Railstars/Io/Io.brd

## EAGLE design Io.brd (2012-02-15)

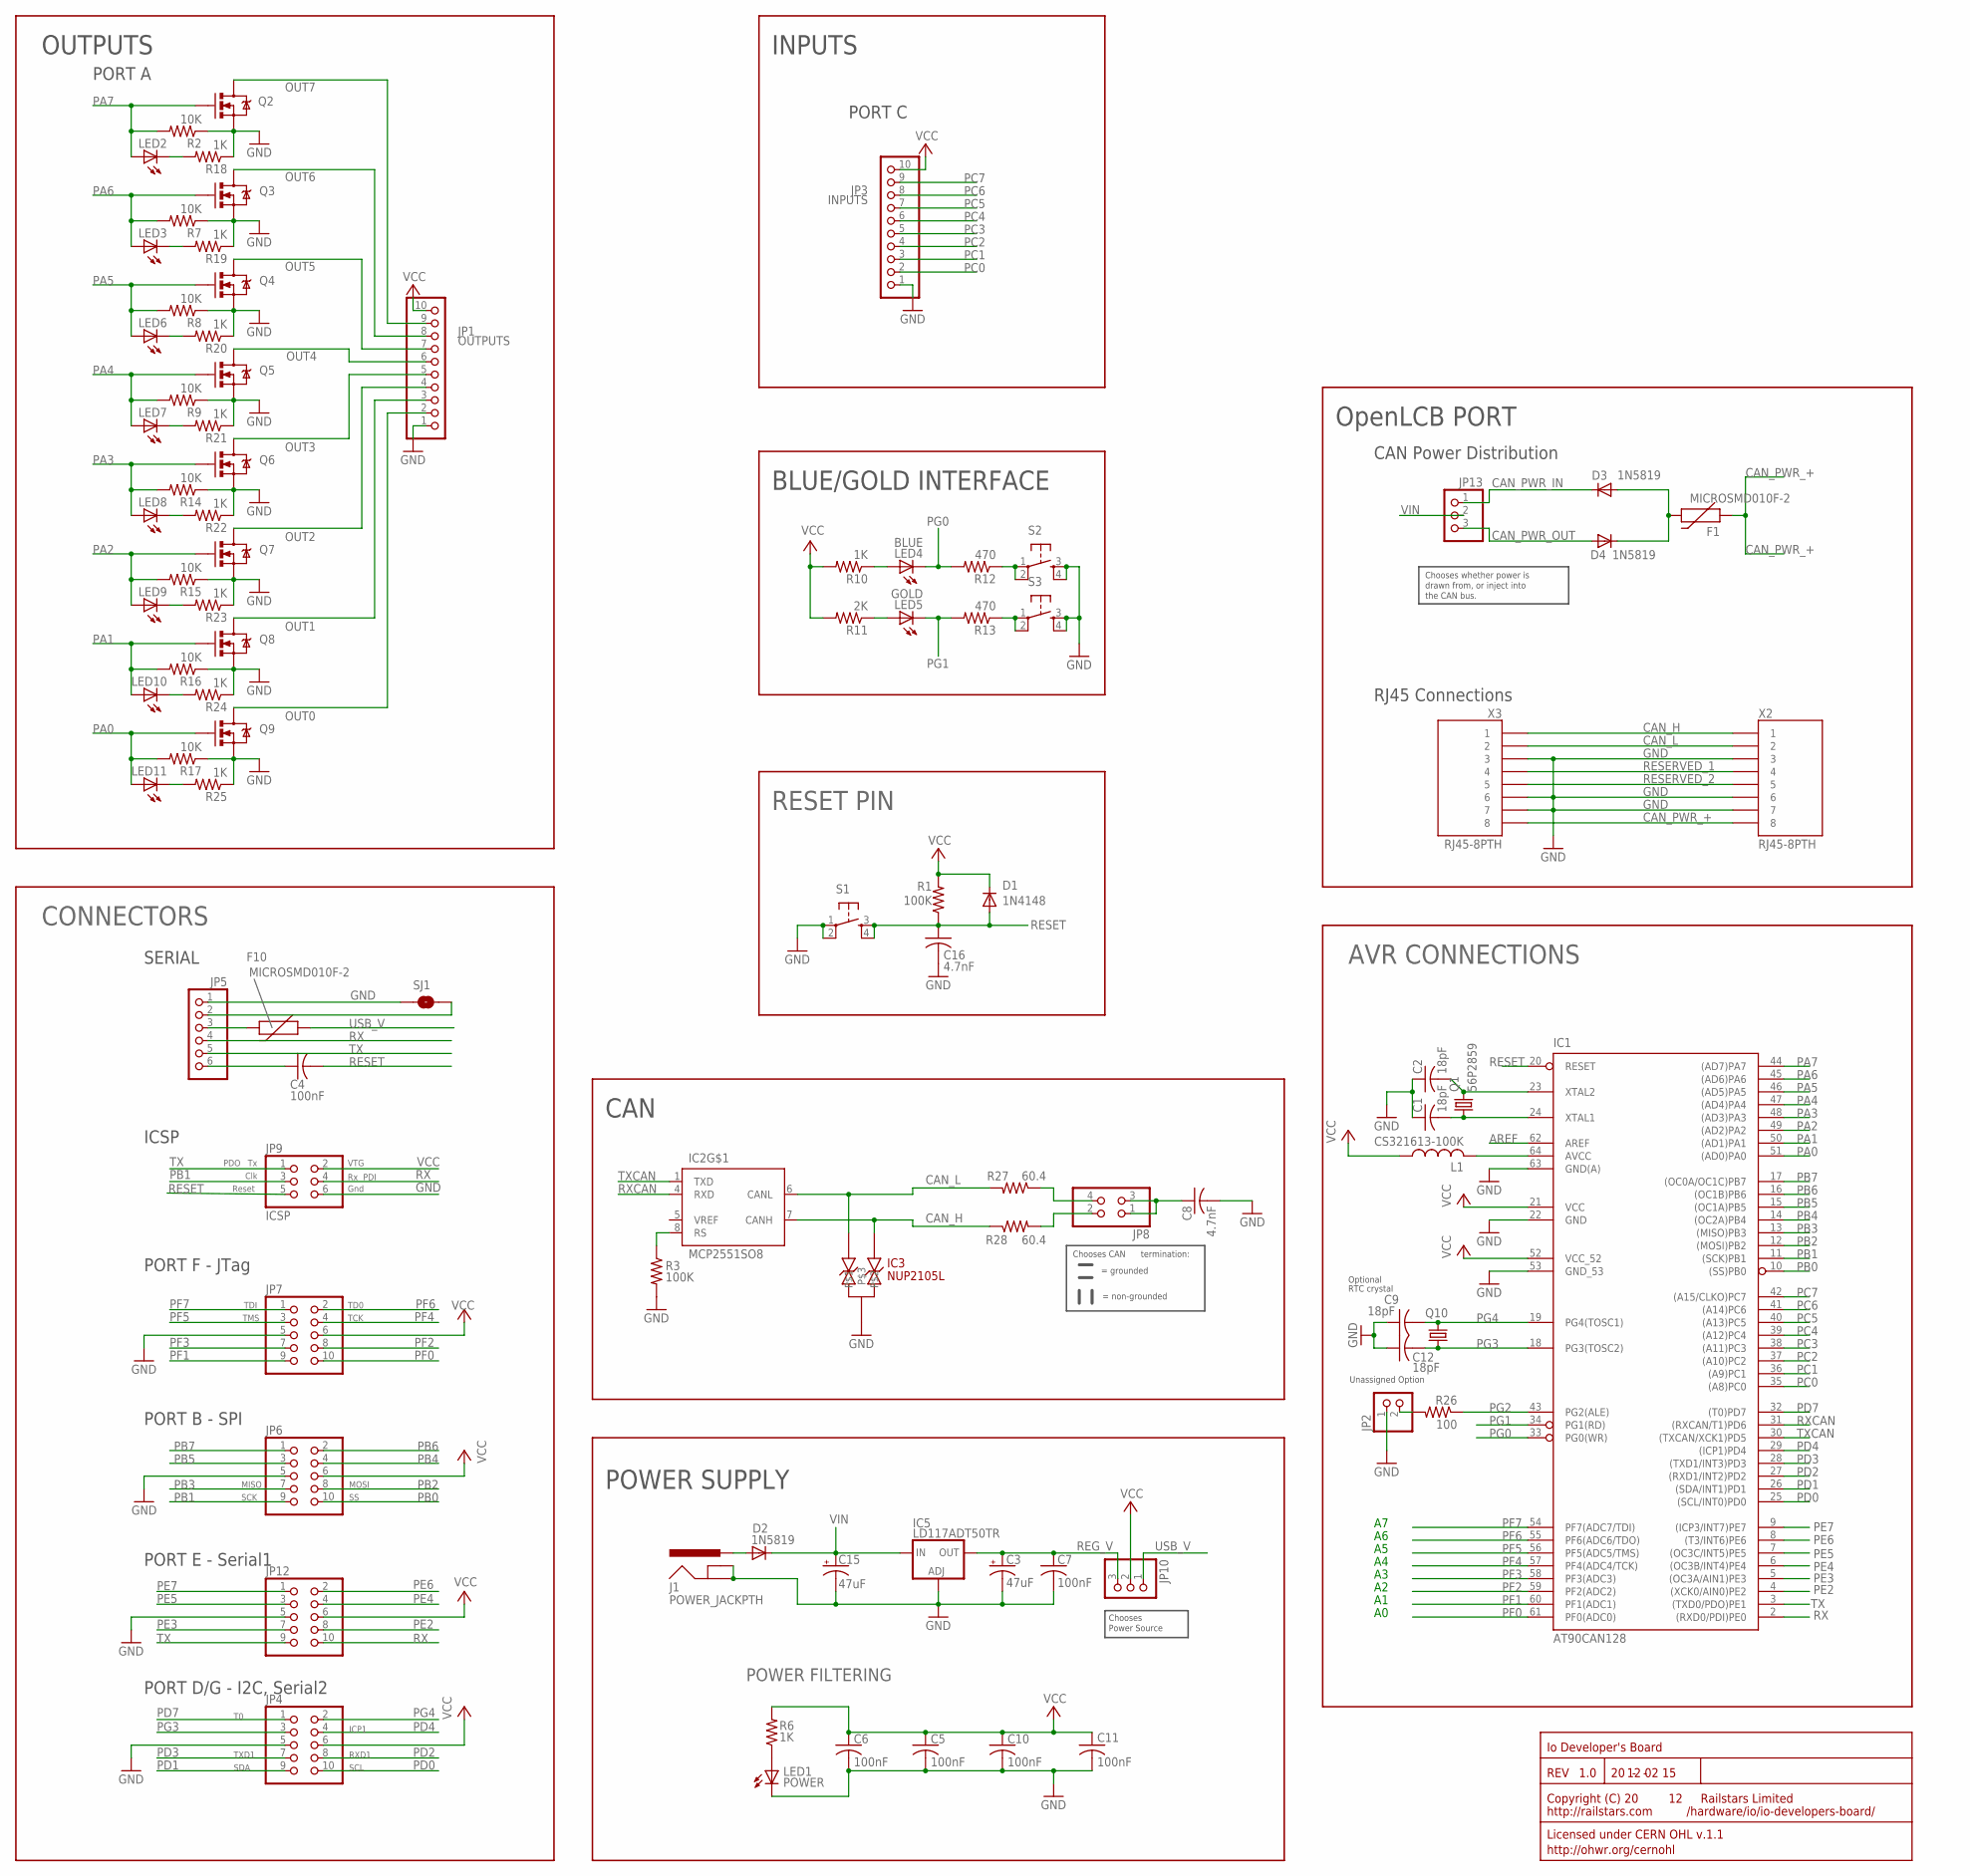
[picture p1: schematic Io.sch]

Parts:
C1, C2, C9, C12: 18pF; C0805
C3, C15: 47uF; UD-6,3X5,8_NICHICON
C4, C5, C6, C7, C10, C11: 100nF; C0805
C8, C16: 4.7nF; C0805
D1: 1N4148; SOD123
D2, D3, D4: 1N5819; SMA-DIODE
F1, F10: MICROSMD010F-2; PTC-1206
IC1: AT90CAN128; TQFP64
IC2: MCP2551SO8; SO08
IC3: NUP2105L; SOT-23
IC5: LD117ADT50TR; DPACK
J1: POWER_JACKPTH; POWER_JACK_PTH
JP1: OUTPUTS; 1X10
JP2: PINHD-1X2; 1X02
JP3: INPUTS; 1X10
JP4, JP6, JP7, JP12: 2X5_HEADERSHROUDED; 2X5_SHROUD
JP5: PINHD-1X6; 1X06
JP8: PINHD-2X2; 2X02
JP9: ICSP; 2X03
JP10, JP13: PINHD-1X3; 1X03
L1: CS321613-100K; L3216C
LED1: POWER; CHIP-LED0805
LED2, LED3, LED6, LED7, LED8, LED9, LED10, LED11: LEDCHIP-LED0805; CHIP-LED0805
LED4: BLUE; CHIP-LED0805
LED5: GOLD; CHIP-LED0805
Q1: 56P2859; HC49/S
Q2, Q3, Q4, Q5, Q6, Q7, Q8, Q9: PMV56XN; SOT23-3
Q10: CRYSTALTC26V; TC26V
R1, R3: 100K; R0805
R2, R7, R8, R9, R14, R15, R16, R17: 10K; R0805
R6, R10, R18, R19, R20, R21, R22, R23, R24, R25: 1K; R0805
R11: 2K; R0805
R12, R13: 470; R0805
R26: 100; R0805
R27, R28: 60.4; R1206
S1, S2, S3: TAC_SWITCHPTH; TACTILE-PTH
SJ1: SOLDERJUMPERTRACE; SJ_2S-TRACE
U$4: RAILSTARS_LOGO50MM; RAILSTARS_50MM
X2, X3: RJ45-8PTH; RJ45-8

Connections:
AREF: IC1.62 (AREF)
CAN_H: IC2.7 (CANH), IC3.2, R28.1, X2.1, X3.1
CAN_L: IC2.6 (CANL), IC3.1, R27.2, X2.2, X3.2
CAN_PWR_+: F1.1, X2.8, X3.8
CAN_PWR_IN: D3.C, JP13.1
CAN_PWR_OUT: D4.A, JP13.3
GND: C1.1, C2.1, C3.-, C5.2, C6.2, C7.2, C8.2, C9.1, C10.2, C11.2, C12.1, C15.-, C16.2, IC1.22 (GND), IC1.53 (GND_53), IC1.63 (GND(A)), IC2.2 (GND), IC3.3, IC5.1 (ADJ), J1.GND, J1.GNDBREAK, JP1.1, JP2.1, JP3.1, JP4.5, JP5.1, JP6.5, JP7.5, JP9.6, JP12.5, LED1.C, Q2.2 (S), Q3.2 (S), Q4.2 (S), Q5.2 (S), Q6.2 (S), Q7.2 (S), Q8.2 (S), Q9.2 (S), R2.1, R3.2, R7.1, R8.1, R9.1, R14.1, R15.1, R16.1, R17.1, R18.1, R19.1, R20.1, R21.1, R22.1, R23.1, R24.1, R25.1, S1.1, S1.2, S2.3, S2.4, S3.3, S3.4, SJ1.2, X2.3, X2.6, X2.7, X3.3, X3.6, X3.7
unnamed: JP8.2, R28.2
unnamed: JP8.4, R27.1
unnamed: LED4.A, R10.1
unnamed: LED5.A, R11.1
unnamed: IC2.8 (RS), R3.1
unnamed: R12.1, S2.1, S2.2
unnamed: F10.2, JP5.3
unnamed: LED1.A, R6.1
unnamed: D2.A, J1.PWR
unnamed: C1.2, IC1.24 (XTAL1), Q1.1
unnamed: R13.1, S3.1, S3.2
unnamed: LED10.C, R24.2
unnamed: LED9.C, R23.2
unnamed: LED8.C, R22.2
unnamed: D3.A, D4.C, F1.2
unnamed: LED7.C, R21.2
unnamed: LED6.C, R20.2
unnamed: LED3.C, R19.2
unnamed: LED2.C, R18.2
unnamed: LED11.C, R25.2
unnamed: IC1.64 (AVCC), L1.2
unnamed: JP5.2, SJ1.1
unnamed: C8.1, JP8.1, JP8.3
unnamed: JP2.2, R26.2
unnamed: C4.1, JP5.6
OUT0: JP1.2, Q9.3 (D)
OUT1: JP1.3, Q8.3 (D)
OUT2: JP1.4, Q7.3 (D)
OUT3: JP1.5, Q6.3 (D)
OUT4: JP1.6, Q5.3 (D)
OUT5: JP1.7, Q4.3 (D)
OUT6: JP1.8, Q3.3 (D)
OUT7: JP1.9, Q2.3 (D)
PA0: IC1.51 ((AD0)PA0), LED11.A, Q9.1 (G), R17.2
PA1: IC1.50 ((AD1)PA1), LED10.A, Q8.1 (G), R16.2
PA2: IC1.49 ((AD2)PA2), LED9.A, Q7.1 (G), R15.2
PA3: IC1.48 ((AD3)PA3), LED8.A, Q6.1 (G), R14.2
PA4: IC1.47 ((AD4)PA4), LED7.A, Q5.1 (G), R9.2
PA5: IC1.46 ((AD5)PA5), LED6.A, Q4.1 (G), R8.2
PA6: IC1.45 ((AD6)PA6), LED3.A, Q3.1 (G), R7.2
PA7: IC1.44 ((AD7)PA7), LED2.A, Q2.1 (G), R2.2
PB0: IC1.10 ((SS)PB0), JP6.10
PB1: IC1.11 ((SCK)PB1), JP6.9, JP9.3
PB2: IC1.12 ((MOSI)PB2), JP6.8
PB3: IC1.13 ((MISO)PB3), JP6.7
PB4: IC1.14 ((OC2A)PB4), JP6.4
PB5: IC1.15 ((OC1A)PB5), JP6.3
PB6: IC1.16 ((OC1B)PB6), JP6.2
PB7: IC1.17 ((OC0A/OC1C)PB7), JP6.1
PC0: IC1.35 ((A8)PC0), JP3.2
PC1: IC1.36 ((A9)PC1), JP3.3
PC2: IC1.37 ((A10)PC2), JP3.4
PC3: IC1.38 ((A11)PC3), JP3.5
PC4: IC1.39 ((A12)PC4), JP3.6
PC5: IC1.40 ((A13)PC5), JP3.7
PC6: IC1.41 ((A14)PC6), JP3.8
PC7: IC1.42 ((A15/CLKO)PC7), JP3.9
PD0: IC1.25 ((SCL/INT0)PD0), JP4.10
PD1: IC1.26 ((SDA/INT1)PD1), JP4.9
PD2: IC1.27 ((RXD1/INT2)PD2), JP4.8
PD3: IC1.28 ((TXD1/INT3)PD3), JP4.7
PD4: IC1.29 ((ICP1)PD4), JP4.4
PD7: IC1.32 ((T0)PD7), JP4.1
PE2: IC1.4 ((XCK0/AIN0)PE2), JP12.8
PE3: IC1.5 ((OC3A/AIN1)PE3), JP12.7
PE4: IC1.6 ((OC3B/INT4)PE4), JP12.4
PE5: IC1.7 ((OC3C/INT5)PE5), JP12.3
PE6: IC1.8 ((T3/INT6)PE6), JP12.2
PE7: IC1.9 ((ICP3/INT7)PE7), JP12.1
PF0: IC1.61 (PF0(ADC0)), JP7.10
PF1: IC1.60 (PF1(ADC1)), JP7.9
PF2: IC1.59 (PF2(ADC2)), JP7.8
PF3: IC1.58 (PF3(ADC3)), JP7.7
PF4: IC1.57 (PF4(ADC4/TCK)), JP7.4
PF5: IC1.56 (PF5(ADC5/TMS)), JP7.3
PF6: IC1.55 (PF6(ADC6/TDO)), JP7.2
PF7: IC1.54 (PF7(ADC7/TDI)), JP7.1
PG0: IC1.33 (PG0(WR)), LED4.C, R12.2
PG1: IC1.34 (PG1(RD)), LED5.C, R13.2
PG2: IC1.43 (PG2(ALE)), R26.1
PG3: C12.2, IC1.18 (PG3(TOSC2)), JP4.3, Q10.1
PG4: C9.2, IC1.19 (PG4(TOSC1)), JP4.2, Q10.2
REG_V: C3.+, C7.1, IC5.4 (OUT), JP10.3
RESERVED_1: X2.4, X3.4
RESERVED_2: X2.5, X3.5
RESET: C4.2, C16.1, D1.A, IC1.20 (RESET), JP9.5, R1.1, S1.3, S1.4
RX: IC1.2 ((RXD0/PDI)PE0), JP5.4, JP9.4, JP12.10
RXCAN: IC1.31 ((RXCAN/T1)PD6), IC2.4 (RXD)
TX: IC1.3 ((TXD0/PDO)PE1), JP5.5, JP9.1, JP12.9
TXCAN: IC1.30 ((TXCAN/XCK1)PD5), IC2.1 (TXD)
USB_V: F10.1, JP10.1
VCC: C5.1, C6.1, C10.1, C11.1, D1.C, IC1.21 (VCC), IC1.52 (VCC_52), IC2.3 (VCC), JP1.10, JP3.10, JP4.6, JP6.6, JP7.6, JP9.2, JP10.2, JP12.6, L1.1, R1.2, R6.2, R10.2, R11.2
VIN: C15.+, D2.C, IC5.3 (IN), JP13.2
XTAL1: C2.2, IC1.23 (XTAL2), Q1.2

Notes on the sheet:
POWER SUPPLY
OpenLCB PORT
CAN
POWER FILTERING
RESET PIN
AVR CONNECTIONS
Io Developer's Board
12 02 15
1.0
/hardware/io/io-developers-board/
BLUE/GOLD INTERFACE
Licensed under CERN OHL v.1.1
http://ohwr.org/cernohl
VTG
Clk
Gnd
Reset
TDI
TD0
TMS
TCK
SCL
SDA
RXD1
TXD1
ICP1
SCK
MOSI
MISO
PDO
PDI
INPUTS
OUTPUTS
CONNECTORS
PORT F - JTag
PORT B - SPI
PORT E - Serial1
PORT D/G - I2C, Serial2
PORT A
PORT C
SERIAL
ICSP
CAN Power Distribution
RJ45 Connections
= non-grounded
= grounded
Chooses CAN
Chooses
Power Source
termination:
Chooses whether power is
drawn from, or inject into
the CAN bus.
Optional
RTC crystal
Unassigned Option

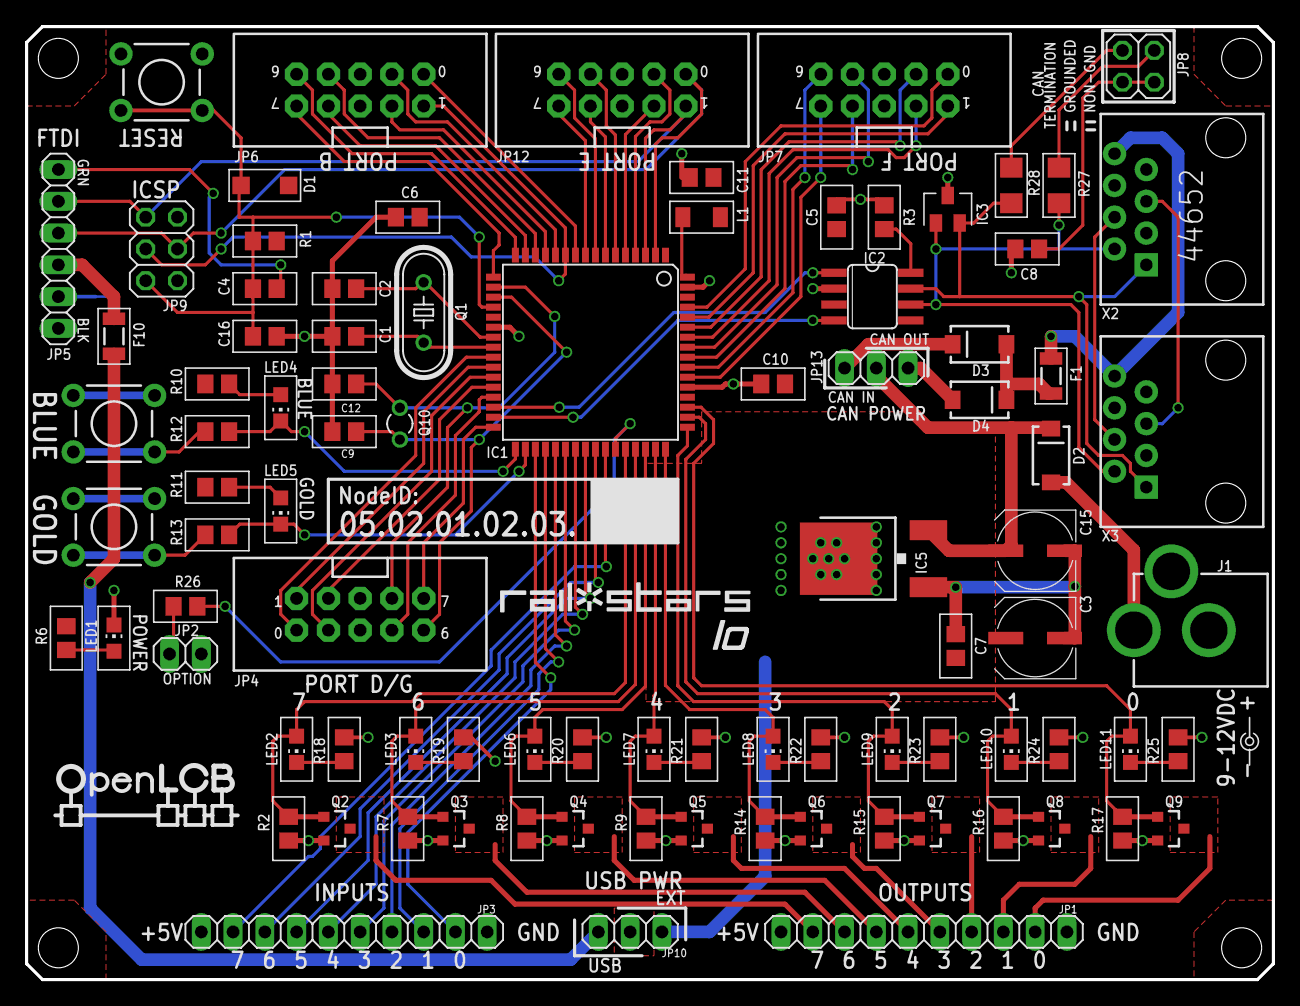
[picture p2: board Io.brd from above]

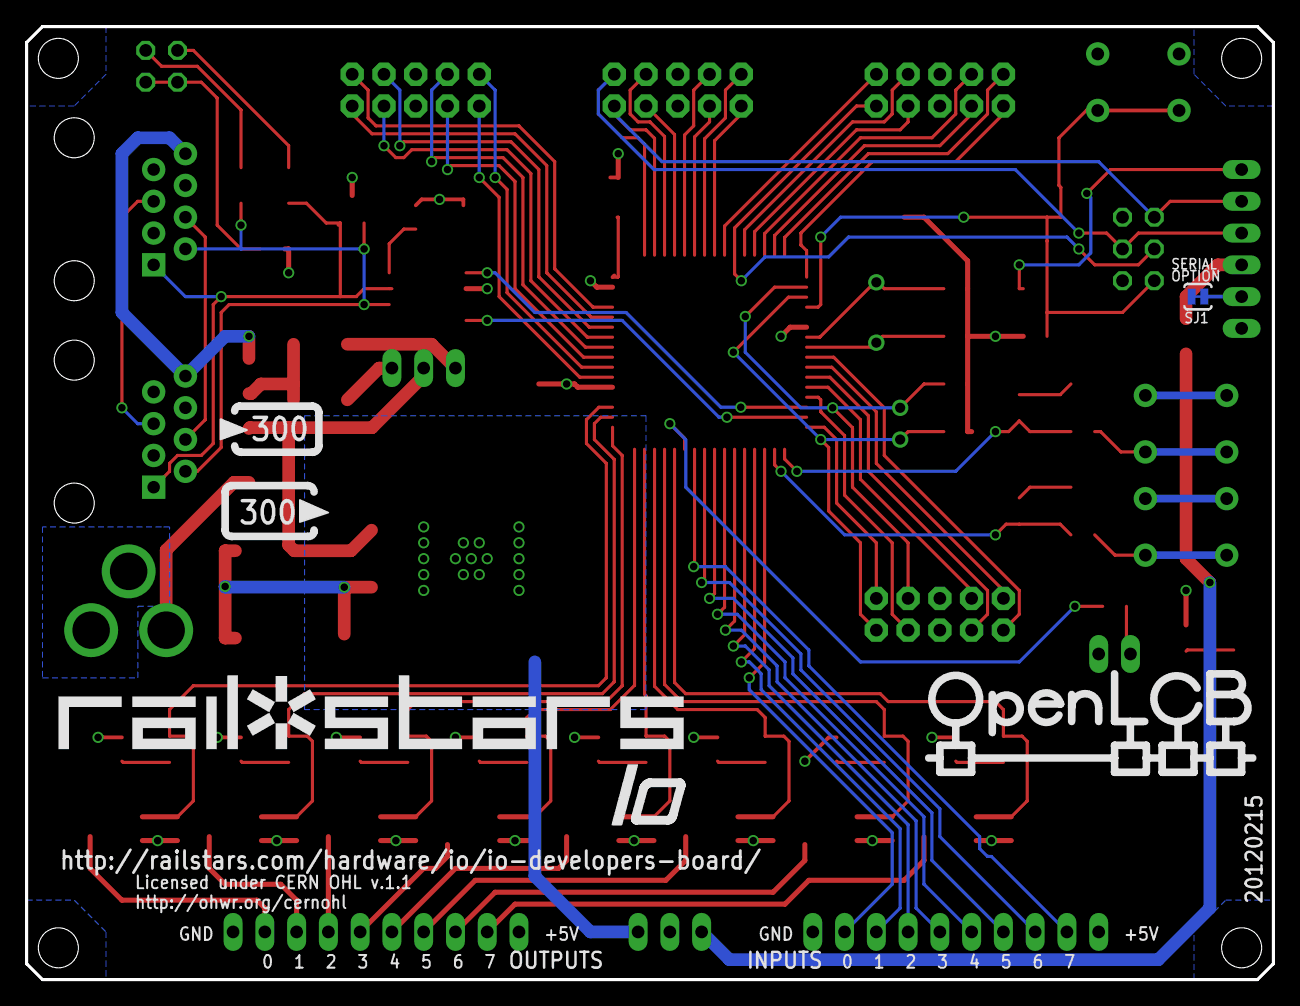
[picture p3: board Io.brd from below]

Board: 2 copper layers, 99.7 x 76.2 mm, 99 parts (3 on the bottom side), 100 nets.

Other parts of the board:
U$1: RAILSTARS_LOGO_IO_V
U$3: RAILSTARS_1IN
U$7: RAILSTARS_LOGO_IO_LARGE_V_INV
U$8: CURRENT_DRAWV_INV
U$9: OPENLCB_LOGOV
U$11: CURRENT_PROVIDEV_INV
U$13: OPENLCB_OPENLCB_LOGO_LARGE
