Railstars/Io/Io_16P_16C_retail/MyConfigHandler.cpp

#include "MyConfigHandler.h"
#include <EEPROM.h>

void MyConfigHandler::create(OLCB_Link *link, OLCB_NodeID *nid, MyEventHandler *eventHandler)
{
  _eventHandler = eventHandler;
  OLCB_Datagram_Handler::create(link,nid);
}


void MyConfigHandler::datagramResult(bool accepted, uint16_t errorcode)
{
  if(!accepted)
  {
  }
}

void MyConfigHandler::initialize(void)
{
  return;
}

uint32_t MyConfigHandler::getAddress(uint8_t* data)
{
  uint32_t val = 0;
  val |= ((uint32_t)data[2]<<24);
  val |= ((uint32_t)data[3]<<16);
  val |= ((uint32_t)data[4]<<8);
  val |= ((uint32_t)data[5]);
  return val;
}

// -1 means stream
uint8_t MyConfigHandler::decodeLength(uint8_t* data) {
  // ToDo:  Add stream
  return data[6];
}

uint8_t MyConfigHandler::decodeSpace(uint8_t* data) {
  int val;
  switch (data[1]&0x03) {
  case 0x03:
    val = 0xFF;
    break;
  case 0x01:
    val = 0xFE;
    break;
  case 0x02:
    val = 0xFD;
    break;
  case 0x00:
    val = data[6];
    break;
  }
  return val;
}

bool MyConfigHandler::processDatagram(void)
{
  //To have made it this far, we can be sure that _rxDatagramBuffer has a valid datagram loaded up, and that it is in fact addressed to us.

  if(!isPermitted()) //only act on it if we are in Permitted state. Otherwise no point.
  {
    return false;
  }
    //Serial..println("got a datagram!");
    //Serial.println(_rxDatagramBuffer->data[0], HEX);
    //check the first byte of the payload to see what kind of datagram we have
    switch(_rxDatagramBuffer->data[0])
    {
    case MAC_PROTOCOL_ID: //MAC protocol
      //Serial..println("using MAC protocol");
      switch (_rxDatagramBuffer->data[1]&0xC0)
      {
      case MAC_CMD_READ:
        //Serial..println("read request");
        return MACProcessRead();
        break;
      case MAC_CMD_WRITE:
        //Serial..println("write request");
        return MACProcessWrite();
        break;
      case MAC_CMD_OPERATION:
        //Serial..println("cmd request");
        return MACProcessCommand();
        break;
      }
    }

  //Serial.println("Not for us to handle, going to NAK");
  return false;
}

//Memory Access Configuration Protocol
bool MyConfigHandler::MACProcessRead(void)
{
  OLCB_Datagram reply;
  memcpy(&(reply.destination), &(_rxDatagramBuffer->source), sizeof(OLCB_NodeID));
  //copy first six bytes. TODO why?
  memcpy(reply.data, _rxDatagramBuffer->data, 6);
  reply.data[1] = MAC_CMD_READ_REPLY | reply.data[1]&0x0F; //WTF?
  //Serial..print("Making reply with MTI ");
  //Serial..println(reply.data[0], HEX);
  //Serial..println(reply.data[1], HEX);
  //TODO presume datagram?
  uint8_t length = decodeLength(_rxDatagramBuffer->data);
  uint32_t address = getAddress(_rxDatagramBuffer->data);
  uint8_t space = decodeSpace(_rxDatagramBuffer->data);
  //And, now do something useful.
  //first check the space?
  switch(space)
  {
  case 0xFF: //CDI request.
    //Serial..println("CDI request.");
    reply.length = readCDI(address, length, &(reply.data[6])) + 6;
    //Serial..print("total length of CDI reply = ");
    //Serial..println(reply.length, DEC);
    return sendDatagram(&reply);
    return true;
  case 0xFE: //"All memory" access. Just give them what they want?
    //Serial..println("all memory request. ignoring");
    break;
  case 0xFD: //configuration space
    //Serial..println("configuration space.");
    reply.length = _eventHandler->readConfig(address, length, &(reply.data[6])) + 6;
    //Serial..print("total length of reply = ");
    //Serial..println(reply.length, DEC);
    return sendDatagram(&reply);
    //return true;
  }
  //Serial..println("NAKing");
  return false; //send a NAK. Is this what we really want?
}

bool MyConfigHandler::MACProcessWrite(void)
{
  uint8_t length = decodeLength(_rxDatagramBuffer->data);
  uint32_t address = getAddress(_rxDatagramBuffer->data);
  uint8_t space = decodeSpace(_rxDatagramBuffer->data);
  //And, now do something useful.
  //first check the space?
  switch(space)
  {
  case 0xFF: //CDI request.
    //TODO
    break;
  case 0xFE: //"All memory" access. Just give them what they want?
    //TODO
    break;
  case 0xFD: //configuration space
    _eventHandler->writeConfig(address, length, &(_rxDatagramBuffer->data[6]));
    return true;
  }
  return false; //send a NAK. Is this what we really want?
}

bool MyConfigHandler::MACProcessCommand(void)
{
  OLCB_Datagram reply;
  reply.data[0] = MAC_PROTOCOL_ID;
  memcpy(&(reply.destination), &(_rxDatagramBuffer->source), sizeof(OLCB_NodeID));
  switch (_rxDatagramBuffer->data[1]&0xFC)
  {
  case MAC_CMD_GET_CONFIG_OPTIONS:
    //Serial.println("MAC_CMD_GET_CONFIG_OPTIONS");
    reply.length = 7;
    reply.data[1] = MAC_CMD_GET_CONFIG_OPTIONS_REPLY;
    reply.data[2] = MAC_CONFIG_OPTIONS_UNALIGNED_READS | MAC_CONFIG_OPTIONS_UNALIGNED_WRITES | MAC_CONFIG_OPTIONS_MFG_ACDI_FD_READ; //available commands byte 1
    reply.data[3] = 0x00; //available commands byte 2
    reply.data[4] = MAC_CONFIG_OPTIONS_1_BYTE_WRITE | MAC_CONFIG_OPTIONS_2_BYTE_WRITE | MAC_CONFIG_OPTIONS_4_BYTE_WRITE | MAC_CONFIG_OPTIONS_64_BYTE_WRITE | MAC_CONFIG_OPTIONS_ARBITRARY_WRITE;
    reply.data[5] = 0xFF; //highest address space
    reply.data[6] = 0xFD; //lowest address space
    sendDatagram(&reply);
    break;
  case MAC_CMD_GET_ADD_SPACE_INFO:
    //Serial.println("MAC_CMD_GET_ADD_SPACE_INFO");
    reply.length = 8; //minimally!
    reply.data[1] = MAC_CMD_GET_ADD_SPACE_INFO_REPLY;
    reply.data[2] = _rxDatagramBuffer->data[2];
    reply.data[3] = 0x00; //largest address
    reply.data[4] = 0x00;
    reply.data[5] = 0x00;
    reply.data[6] = 0x00; //largest address continued
    reply.data[7] = 0x00; //byte alignment flags; we require no byte alignment
    switch(_rxDatagramBuffer->data[2])
    {
    case 0xFF: //CDI
      reply.data[1] |= 0x01; //present
      reply.data[3] = (uint32_t)(sizeof(cdixml))>>24 & 0xFF;
      reply.data[4] = (uint32_t)(sizeof(cdixml))>>16 & 0xFF;
      reply.data[5] = (uint32_t)(sizeof(cdixml))>>8 & 0xFF;
      reply.data[6] = (uint32_t)(sizeof(cdixml)) & 0xFF;
      break;
    case 0xFE: //"all memory"
      break;
    case 0xFD: //configuration space
      reply.data[1] |= 0x01; //present
      //largest address is.
      reply.data[3] = _eventHandler->getLargestAddress()>>24 & 0xFF;
      reply.data[4] = _eventHandler->getLargestAddress()>>16 & 0xFF;
      reply.data[5] = _eventHandler->getLargestAddress()>>8 & 0xFF;
      reply.data[6] = _eventHandler->getLargestAddress() & 0xFF;
      break;
    }
    sendDatagram(&reply);
    break;
  case MAC_CMD_RESETS:
    //Serial.println("MAC_CMD_RESETS");
    // force restart (may not reply?)
    if ((_rxDatagramBuffer->data[1]&0x03) == 0x01)
    { // restart/reboot?
      //TODO tell other handlers that we need to write out anything that needs to be saved!!!
      void (*restart)() = 0x00;
      (*restart)();
    }
    else if((_rxDatagramBuffer->data[1]&0x03) == 0x02) //factory reset!
    {
      //check NID first!
      OLCB_NodeID n;
      memcpy(&n, &(_rxDatagramBuffer->data[2]), 6);
      if(n.sameNID(NID))
      {
        _eventHandler->factoryReset();
        void (*restart)() = 0x00;
        (*restart)();
      }
    }
    // TODO: Handle other cases
    break;
  case MAC_CMD_LOCK:
    //Serial.println("MAC_CMD_LOCK");
    break;
  case MAC_CMD_GET_UNIQUEID:
    //Serial.println("MAC_CMD_GET_UNIQUEID");
    {
      uint8_t num = (_rxDatagramBuffer->data[2] & 0x07);
      reply.length = 2+(8*num);
      reply.data[1] = MAC_CMD_GET_UNIQUEID_REPLY;
      uint8_t eid6 = EEPROM.read(2);
      uint8_t eid7 = EEPROM.read(3);
      for(uint8_t i = 0; i < num; ++i)
      {
        for(uint8_t j = 0; i < 6; ++j)
        {
          reply.data[(i*8)+j+2] = NID->val[j];
        }
        reply.data[(i*8)+7+2] = eid6;
        reply.data[(i*8)+8+2] = eid7;
        if(eid7 == 254) //need to increment val[6] as well
        {
          eid6++; //might wrap around to 0; it's gonna happen, I guess
        }
        eid7++;
      }
      sendDatagram(&reply);
      EEPROM.write(2,eid6);
      EEPROM.write(3,eid7);
    }
    break;
  case MAC_CMD_FREEZE:
    //Serial.println("MAC_CMD_FREEZE");
    break;
  case MAC_CMD_INDICATE:
    //Serial.println("MAC_CMD_INDICATE");
    break;
  default:
    break;
  }
}

uint8_t MyConfigHandler::readCDI(uint16_t address, uint8_t length, uint8_t *data)
{
  //This method gets called by configuration handlers. We are being requested for the CDI file, a chunk at a time.
  //Serial.println("readCDI");
  //Serial.print("length: ");
  //Serial.println(length);
  uint16_t capacity = sizeof(cdixml)+1;
  if( (length+address) > (capacity) ) //too much! Would cause overflow
    //caculate a shorter length to prevent overflow
    length = capacity - address;
  //Serial.print("modified length: ");
  //Serial.println(length);
  //Serial.print("Read from index ");
  //Serial.println(address, DEC);
  //we can't do a straight memcpy, because xmlcdi is PROGMEM. So, we have to use read_bytes instead
  uint16_t i;
  for(i = 0; i < length; ++i)
  {
    if( (i+address) >= sizeof(cdixml) )
    {
      *(data+(i)) = 0;
    }
    else
    {
      *(data+(i)) = pgm_read_byte(&cdixml[i+address]);
    }
  }
  //Serial.println("===");
  //for(i = 0; i < length; ++i)
    //Serial.println(*(data+i), HEX);
    return length;
}
