Railstars/Io/(commit log)

2011-12-05 daughter REV B
    [Io.brd, Io.sch]
2011-12-06 daughter REV C
    [Io.brd, Io.sch]
2011-12-10 daughter REV D-BACKUP
    [Io.brd, Io.sch]
2011-12-10 IO 20111210
    [Io.brd, Io.sch]
2011-12-11 IO 20111211
    [Io.brd, Io.sch]
2011-12-11 IO 20111212
    [Io.brd, Io.sch]
2011-12-12 IO 20111213
    [Io.brd, Io.sch]
2011-12-13 IO 20111214
    [Io.brd, Io.sch]
2011-12-14 IO 20111215
    [Io.brd, Io.sch]
2012-01-30 Io 20120103
    [Io.brd, Io.sch]
2012-02-15 Io 20120215
    [Io.brd, Io.sch]
