Railstars/Io/(notices)

Notices in the files:
Io.brd:
Copyright (C) 2012 D.E. Goodman-Wilson
parts and their libraries:
Artificial Science: Copyright (C) 20
